RumethRanhinda/Analog-Metal-Detector/Images/3D_PCB.png

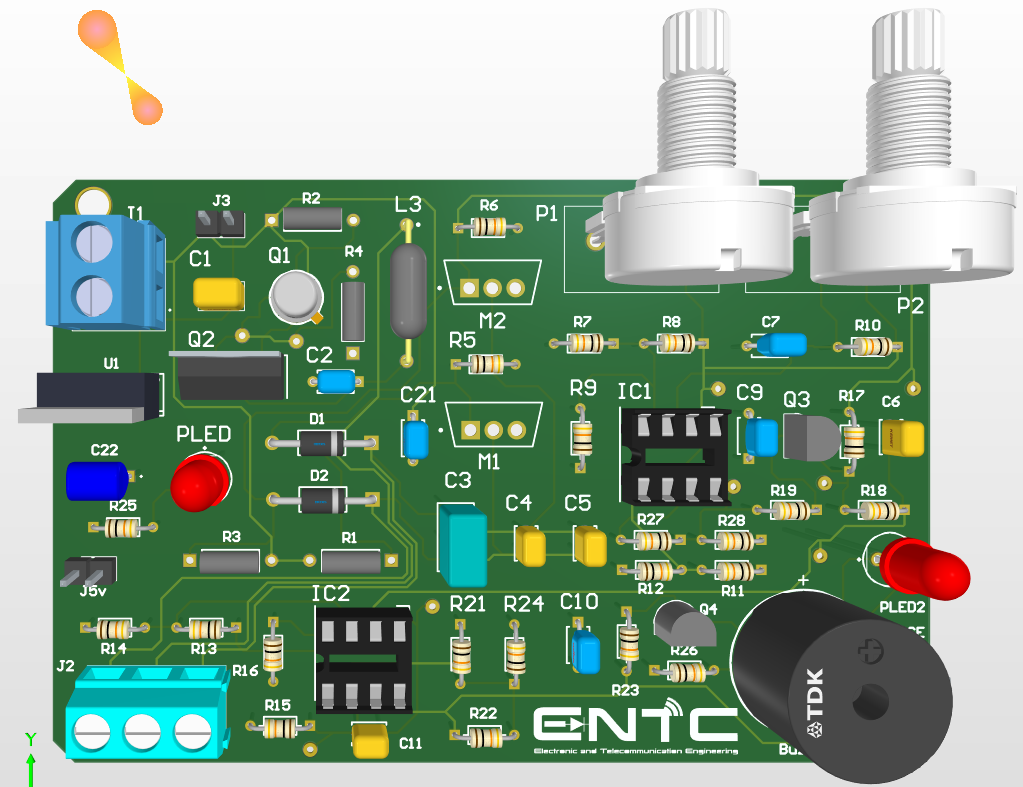
Images/3D_PCB.png
