RumethRanhinda/Analog-Metal-Detector/Images/PCB_routing.png

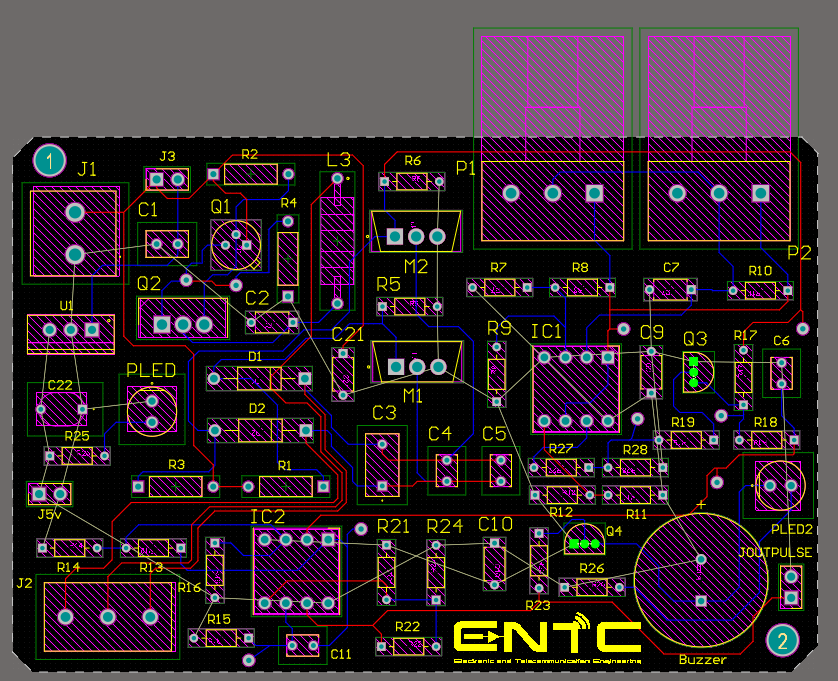
Images/PCB_routing.png
