RumethRanhinda/Analog-Metal-Detector/Simulation/Model 2.asc

C1: cap; 150n
C2: cap; 100µ
C3: cap; 100µ
C4: cap; 0.1µ
C5: cap; 47n
C6: cap; 100n
C7: cap; 100n
C8: cap; 100n
C9: cap; 25n
C10: cap; 100n
C11: cap; 10n
C12: cap; 0.33µ
C13: cap; 10n
C14: cap; 10n
D1: diode; 1N5819
D2: diode; 1N5819
L1: ind2; 400µ
L2: ind2; 400µ
L3: ind; 100µ
L7805CV: 78L05C
M1: nmos; IRFZ44N
M2: nmos; IRFZ44N
Q1: pnp; 2N3906
Q2: pnp; 2N2907
Q3: npn; 2N3904
Q4: npn; 2N3904
R1: res; 150
R2: res; 1
R3: res; 150
R4: res; 2.2k
R5: res; 10k
R6: res; 10k
R7: res; 10k
R8: res; 100
R9: res; 10k
R10: res; 39k
R11: res; 1k
R12: res; 10k
R13: res; 10k
R14: res; 10k
R15: res; 10K
R16: res; 10k
R17: res; 10k
R18: res; 22k
R19: res; 10k
R20: res; 1k
R22: res; 10k
R23: res; 10k
R25: res; 10k
R26: res; 10k
U1: opamp2; MCP6001
U2: opamp2; MCP6001
U3: opamp2; MCP6001
U4: opamp2; MCP6001
V1: voltage; 9
Named nets: 0, Out1, 9v, 5v, 25kOut2
.tran 1m
K L1 L2 1
C = 170nF
1/(2pi*sqrt(LC))=25 kHz
CL1 limits the current
Royer oscillator
Diodes need to be fast schottky
L3 avoids spikes on power supply.
 
Schottky diode and 10k resistor on 
mosfet gate are used to avoid spikes
on the mosfet gate
CL1
9v to 5v Regulation
.include AS78L05C.lib
variable oscillator
Schimitt trigger Local oscillator
.include LM358.lib
Multiplier
RC Filter
Comparator
High 
Pass 
Filter
Comparator
with ZVS mosfets
2SB596 MOSFET
L7805CV
MCP6001
MCP6001
MCP6001
MCP6001
Buzzer
.include MCP6001.lib
