RumethRanhinda/Analog-Metal-Detector/Simulation/Metal_Royer-zvs.asc

C1: cap; 100n
C2: cap; 100n
C3: cap; 100µ
D1: diode; 1N5819
D2: diode; 1N5819
L1: ind2; 115µ
L2: ind2; 115µ
L3: ind; 100µ
M1: nmos; IRFZ44N
M2: nmos; IRFZ44N
Q1: pnp; 2N2907
Q2: pnp; 2N3906
R1: res; 150
R2: res; 1
R3: res; 150
R4: res; 2.2k
V1: voltage; 9
Named nets: 0, Out125k, 9v
.tran 1m
K L1 L2 1
C = 100nF
1/(2pi*sqrt(LC))=25 kHz
CL1 limits the current
Royer oscillator 
       with ZVS mosfets
Diodes need to be fast schottky
L3 avoids spikes on power supply.
 
Zener diode and 10k resistor on 
mosfet gate are used to avoid spikes
on the mosfet gate
CL1
