RumethRanhinda/Analog-Metal-Detector/Simulation/Model 1.asc

78L05C: 78L05C
C1: cap; 150n
C2: cap; 100µ
C3: cap; 100µ
C4: cap; 100µF
C5: cap; 1n
C6: cap; 100n
C7: cap; 1n
C8: cap; 100n
C9: cap; 100p
C10: cap; 100n
C11: cap; 1n
C12: cap; 1n
D1: diode; 1N5819
D2: diode; 1N5819
L1: ind2; 140µ
L2: ind2; 140µ
L3: ind; 100µ
M1: nmos; IRFZ44N
M2: nmos; IRFZ44N
Q1: pnp; 2N3906
Q2: pnp; 2N2907
Q3: npn; 2N3904
Q4: npn; 2N3904
Q5: npn; 2N2222
Q6: npn; 2N2222
R1: res; 150
R2: res; 0.8
R3: res; 150
R4: res; 2.2k
R5: res; 100k
R6: res; 100k
R7: res; 100k
R8: res; 10k
R9: res; 10k
R10: res; 10k
R11: res; 1k
R12: res; 10k
R13: res; 10k
R14: res; 10k
R15: res; 22k
R16: res; 10k
R17: res; 10k
R18: res; 22k
R19: res; 10k
R20: res; 1k
R21: res; 1k
R22: res; 100k
R23: res; 100k
R24: res; 1k
R25: res; 10k
R26: res; 10k
U1: opamp2; LM358
U2: opamp2; LM358
U3: opamp2; LM358
V1: voltage; 9
Named nets: 0, Out1, 9v, 5v, 25kOut2
.tran 1m
K L1 L2 1
C = 100nF
1/(2pi*sqrt(LC))=25 kHz
CL1 limits the current
Royer oscillator
Diodes need to be fast schottky
L3 avoids spikes on power supply.
 
Zener diode and 10k resistor on 
mosfet gate are used to avoid spikes
on the mosfet gate
CL1
9v to 5v Regulation
.include AS78L05C.lib
variable oscillator
Schimitt trigger Local oscillator
.include LM358.lib
Multiplier
RC Filter
Comparator
High 
Pass 
Filter
Comparator
with ZVS mosfets
Transistor based Square Wave Oscillator
.include MCP6001.lib
